HexabitzPlatform/P01R0x-Hardware/README.md

# P01R0x-Hardware
Hexabitz RGB LED Module Hardware Design
