HexabitzPlatform/P01R0x-Hardware/Released/BOM/P01R0.xlsx

 |  | www.hexabitz.com info@hexabitz.com |  | Bill Of Materials
Customer | Hexabitz | Revision | 1
Project | Hexabitz Modules | Date | 2024-02-21
Board | RGB LED (P01R0) | Notes
Designator | Description | Manufacturer | Manufacturer Part Number | Octopart Url | Quantity
R | Conn Unshrouded Header HDR 1 POS Solder ST Top Entry Thru-Hole Carton | TE Connectivity | 103327-1 | https://octopart.com/103327-1-te+connectivity-1934117?r=sp | 1
SWD | Conn Unshrouded Header HDR 3 POS 2.54mm Solder ST Top Entry Thru-Hole Carton | TE Connectivity | 5-146281-3 | https://octopart.com/5-146281-3-te+connectivity+%2F+amp-39745942?r=sp | 1
C1, C5, C6 | CAP CER 0.1 UF 10% X7R 0603 | KEMET | C0603C104K8RACTU | https://octopart.com/c0603c104k8ractu-kemet-145075?r=sp&s=9bS9ASSwSEqMCE9KBEQZ0g | 3
C2 | CAP CER 1 UF 16V X7R 0805 | YAGEO | CC0805KKX7R7BB105 | https://octopart.com/cc0805kkx7r7bb105-yageo-8376555?r=sp | 1
C7 | CAP TANT 4.7 UF 10V 20% 0805 | Panasonic | 10TPU4R7MSI | https://octopart.com/10tpu4r7msi-panasonic-29487748?r=sp | 1
R1 | Thick Film Resistors - SMD 0603 270 Ohm 5% Tol | Panasonic | ERJ-3GEYJ271V | https://octopart.com/erj-3geyj271v-panasonic-55560546?r=sp | 1
R2 | RES SMD 0.0OHM JUMPER 1/10W 0603 | YAGEO | RC0603JR-070RL | https://octopart.com/rc0603jr-070rl-yageo-1241539?r=sp | 1
R3 | RES 10K Ohm 5% 0603 | Vishay | CRCW060310K0JNEB | https://octopart.com/crcw060310k0jneb-vishay-46603269 | 1
R4 | Thick Film Resistors - SMD 0603 68 Ohm 1% | Vishay | CRCW060368R0FKEA | https://octopart.com/crcw060368r0fkea-vishay-39811903 | 1
R5, R6 | Thick Film Resistors - SMD 0603 10 Ohm 1% | Vishay | CRCW060310R0FKEB | https://octopart.com/crcw060310r0fkeb-vishay-42507905 | 2
R7, R8, R9 | Thick Film Resistors - SMD 0603 2.4K Ohm 1% | Vishay | CRCW06032K40JNEA | https://octopart.com/crcw06032k40jnea-vishay-40298967 | 3
FB1 | Ind chip Bead Multi-Layer 30 ohms 25% 100MHZ Ferrite 1,5A 0603Punched paper T/R | TDK | MMZ1608Y300BTA00 | https://octopart.com/mmz1608y300bta00-tdk-7906990?r=sp | 1
Q1, Q2, Q3 | Transistor, Bipolar, Si, NPN, General Purpose, VCEO 40VDC, IC 200mA, PD 225mW, SOT-23 | ON Semiconductor | MMBT3904LT1G | https://octopart.com/mmbt3904lt1g-on+semiconductor-3280?r=sp | 3
U1 | MCU 32-Bit ARM Cortex-M0+ RISC 512kByte Flash 1.7V to 3.6V 48-Pin UFQFPN Tray | STM32G0B1CEU6 | STMicroelectronics | https://octopart.com/stm32g0b1ceu6-stmicroelectronics-116363364?r=sp | 1
D1 | Red 0603 130° Clear 54 mcd 2 V Surface Mount ChipLED | Vishay | VLMS1300-GS08 | https://octopart.com/vlms1300-gs08-vishay-21709201?r=sp&s=0nXJNjGsSbWwqfqWlZv0EA | 1
D2 | LED, HB, RGB, SMD, 130mW | Wolfspeed (https://octopart.com/manufacturers/wolfspeed) | CLVBA-FKA-CC1F1L1BB7R3R3 | https://octopart.com/clvba-fka-cc1f1l1bb7r3r3-cree-20054005 | 1
D3 | TVS DIODE 3,3V 10,9V SOD323 | BOURNS | CDSOD323-T03SC | https://octopart.com/cdsod323-t03sc-bourns-10487153?r=sp | 1
X1 | 8,0000MHZ 33pF SMD MURATA Resonators | Murata | CSTNE8M00G550000R0 | https://octopart.com/cstne8m00g550000r0-murata-91406934?r=sp | 1
