HexabitzPlatform/P01R0x-Hardware/Documentation/P01R0_Schematics.pdf

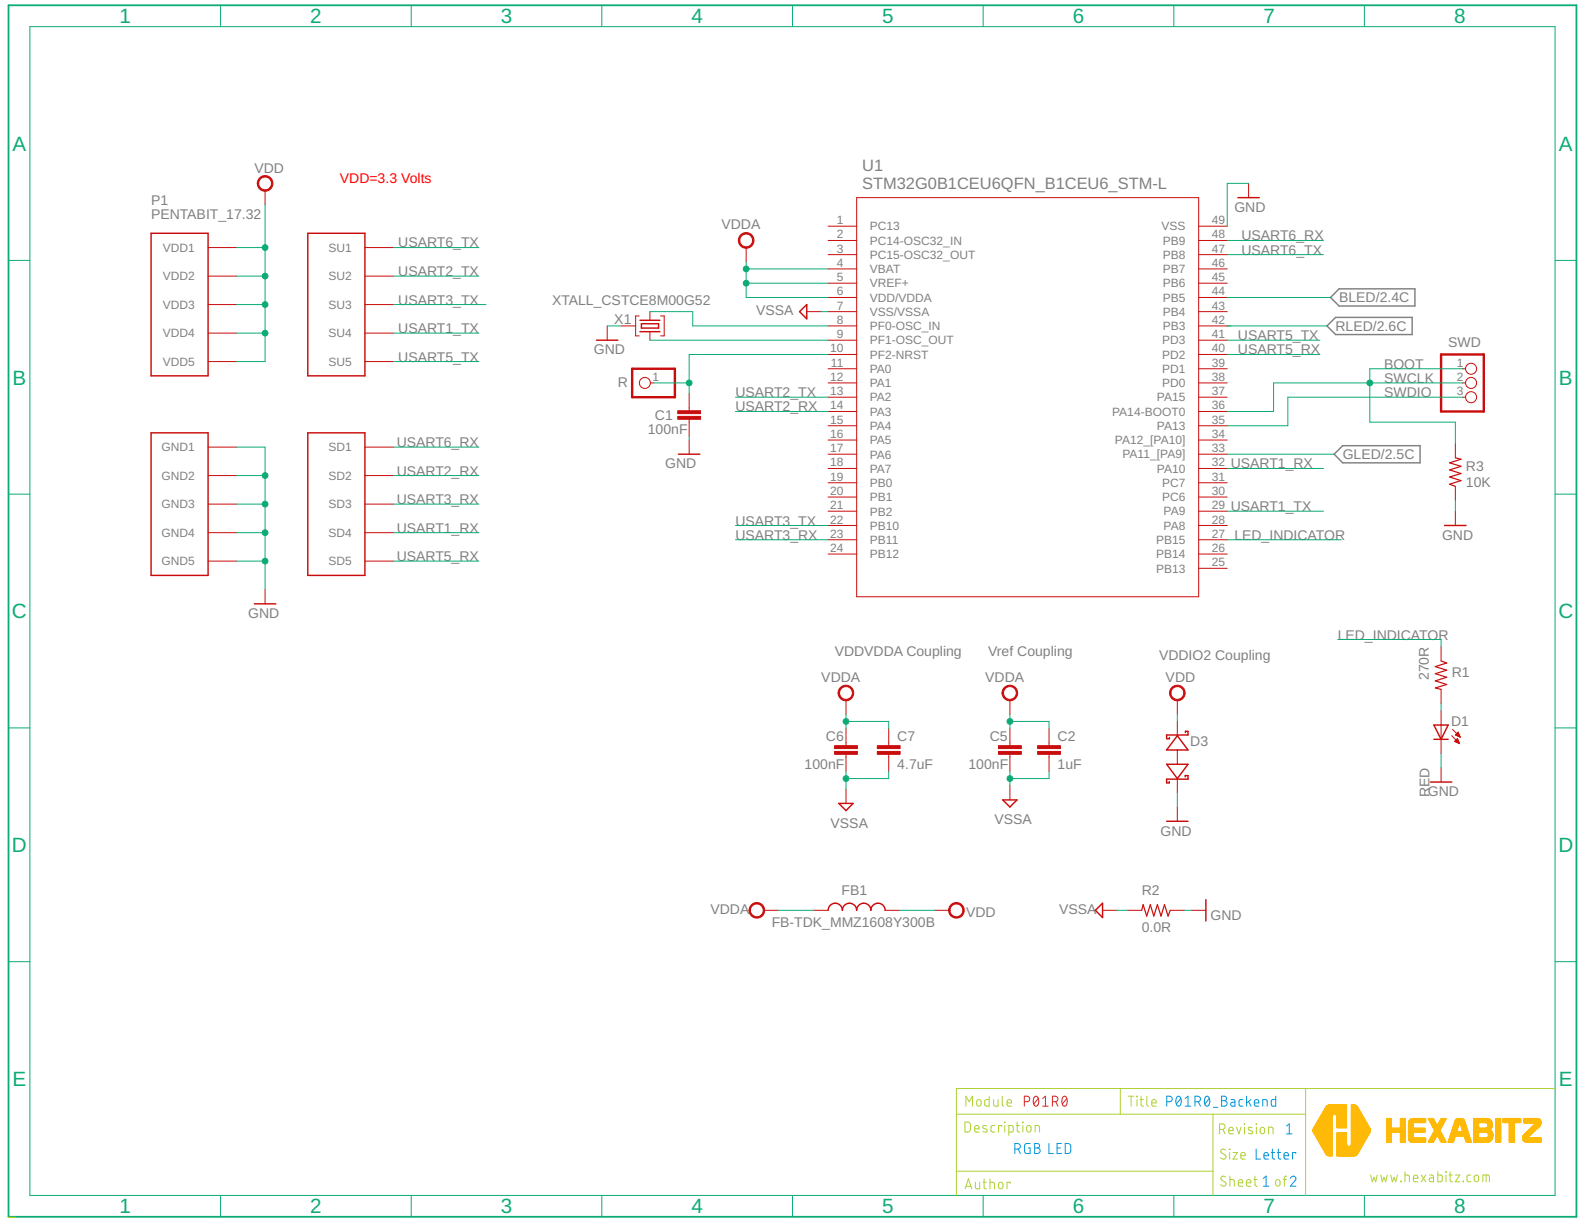
[picture p1: page 1]

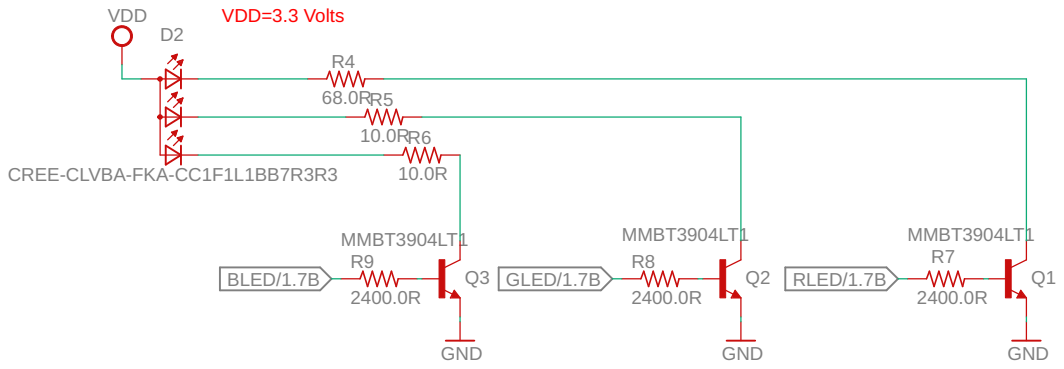
[picture p2: page 2]
