HexabitzPlatform/P01R0x-Hardware/Design/P01R0.brd

## EAGLE design Design/P01R0.brd (2024-07-14)

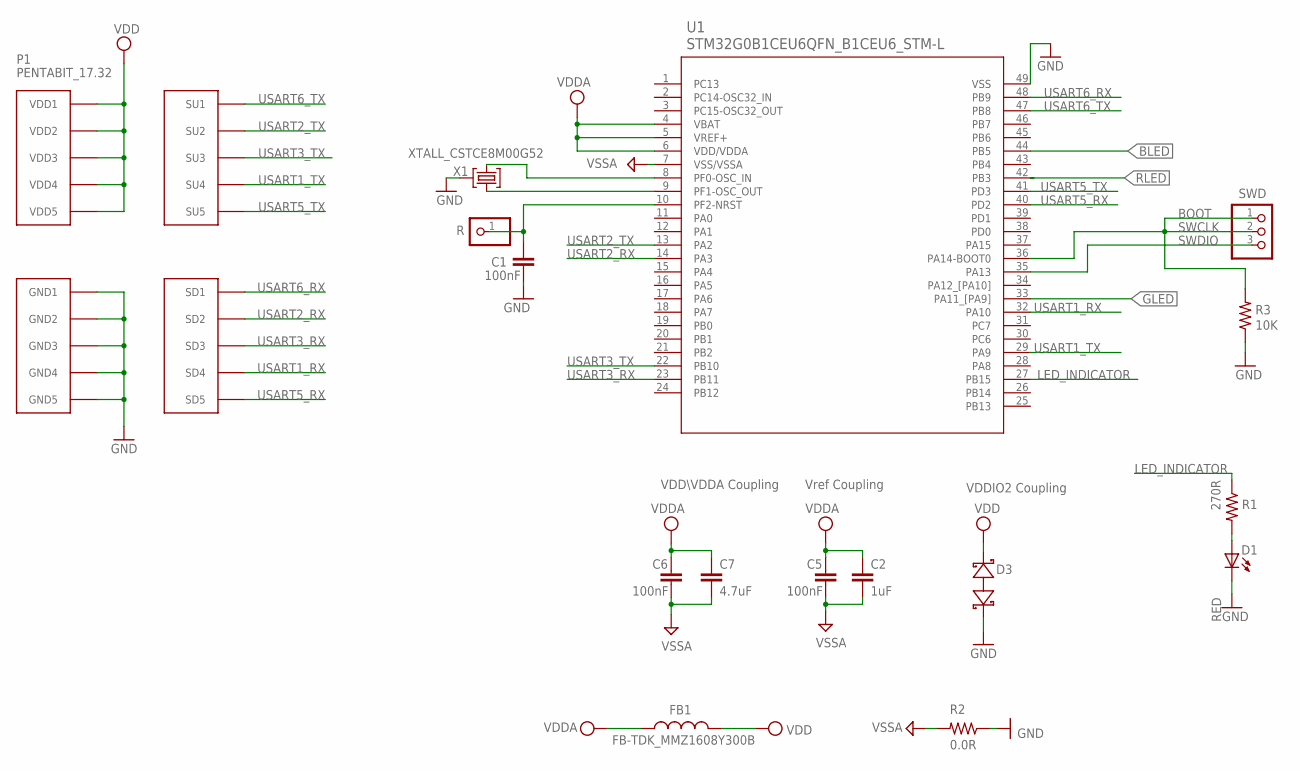
[picture p3: schematic P01R0.sch, sheet 1]

Parts:
C1, C5, C6: 100nF; C-0603
C2: 1uF; C-0805
C7: 4.7uF; C-0805
D1: RED; VLMS1300-GS08; MPN VLMS1300-GS08
D3: BOURNS_CDSOD323-T03SCBOURNS_CDSOD323-T03SC_0_0; BOURNS_CDSOD323-T03SC_0
FB1: FB-TDK_MMZ1608Y300B; FB-0603; MPN MMZ1608Y300B
P1: PENTABIT_17.32
R: R; 1X01
R1: 270R; R-0603
R2: 0.0R; R-0603; MPN RC0603JR-070RL
R3: 10K; R-0603
SWD: PINHD-1X3; 1X03
U1: STM32G0B1CEU6QFN_B1CEU6_STM-L; QFN_B1CEU6_STM-L
X1: XTALL_CSTCE8M00G52

Connections:
BLED: U1.44 (PB5); also elsewhere on the board
GLED: U1.33 (PA11_[PA9]); also elsewhere on the board
GND: C1.2, D1.C, D3.1 (A), P1.PAD_PD6 (GND1), P1.PAD_PD7 (GND2), P1.PAD_PD8 (GND3), P1.PAD_PD9 (GND4), P1.PAD_PD10 (GND5), R2.1, R3.1, U1.49 (VSS), X1.P$2 (2); also elsewhere on the board
LED_INDICATOR: R1.1, U1.27 (PB15)
unnamed: D1.A, R1.2
OSC_IN: U1.8 (PF0-OSC_IN), X1.P$3 (3)
OSC_OUT: U1.9 (PF1-OSC_OUT), X1.P$1 (1)
R: C1.1, R.1, U1.10 (PF2-NRST)
RLED: U1.42 (PB3); also elsewhere on the board
SWCLK: R3.2, SWD.1, SWD.2, U1.36 (PA14-BOOT0)
SWDIO: SWD.3, U1.35 (PA13)
USART1_RX: P1.PAD_PD4 (SD4), U1.32 (PA10)
USART1_TX: P1.PAD_PU4 (SU4), U1.29 (PA9)
USART2_RX: P1.PAD_PD2 (SD2), U1.14 (PA3)
USART2_TX: P1.PAD_PU2 (SU2), U1.13 (PA2)
USART3_RX: P1.PAD_PD3 (SD3), U1.23 (PB11)
USART3_TX: P1.PAD_PU3 (SU3), U1.22 (PB10)
USART5_RX: P1.PAD_PD5 (SD5), U1.40 (PD2)
USART5_TX: P1.PAD_PU5 (SU5), U1.41 (PD3)
USART6_RX: P1.PAD_PD1 (SD1), U1.48 (PB9)
USART6_TX: P1.PAD_PU1 (SU1), U1.47 (PB8)
VDD: D3.2 (C), FB1.2, P1.PAD_PU6 (VDD1), P1.PAD_PU7 (VDD2), P1.PAD_PU8 (VDD3), P1.PAD_PU9 (VDD4), P1.PAD_PU10 (VDD5); also elsewhere on the board
VDDA: C2.1, C5.1, C6.1, C7.1, FB1.1, U1.4 (VBAT), U1.5 (VREF+), U1.6 (VDD/VDDA)
VSSA: C2.2, C5.2, C6.2, C7.2, R2.2, U1.7 (VSS/VSSA)

Notes on the sheet:
Vref Coupling
VDDIO2 Coupling
VDD\VDDA Coupling
BOOT

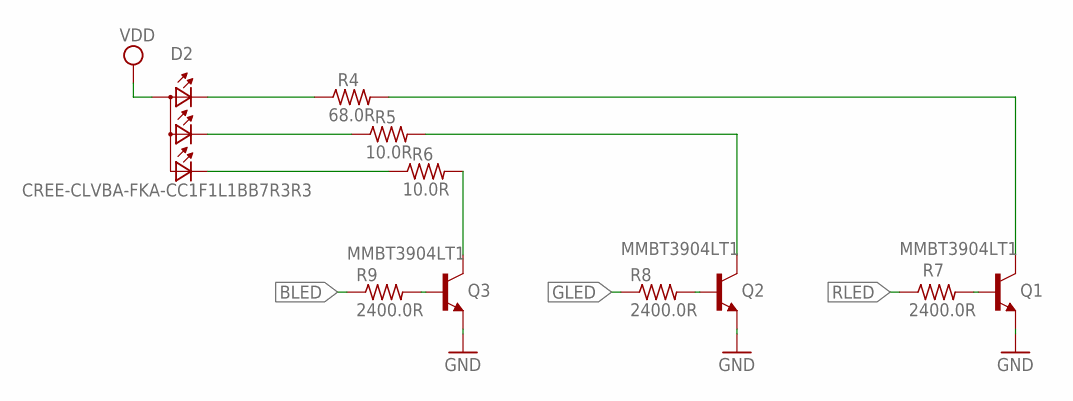
[picture p4: schematic P01R0.sch, sheet 2]

Parts:
D2: CREE-CLVBA-FKA-CC1F1L1BB7R3R3; PCB-1023943-1; MPN CLVBA-FKA-CC1F1L1BB7R3R3
Q1, Q2: MMBT3904LT1; VOLTAGE_RATING_DC 40.0V
Q3: MMBT3904LT1; VOLTAGE_RATING_DC 40.0V; MPN MMBT3904LT1G
R4: 68.0R; R-0603; TOLERANCE 1%; MPN CRCW060368R0FKEA
R5, R6: 10.0R; R-0603; TOLERANCE 1%; MPN CRCW060310R0FKEB
R7, R8, R9: 2400.0R; R-0603; TOLERANCE 5%; MPN CRCW06032K40JNEA
TRIMBLE-LOGO1: HEXA-LOGO

Connections:
BLED: R9.1; also elsewhere on the board
GLED: R8.1; also elsewhere on the board
GND: Q1.2 (E), Q2.2 (E), Q3.2 (E); also elsewhere on the board
KA_B: D2.P$3 (CBLUE), R6.1
KA_G: D2.P$4 (CGREEN), R5.1
KA_R: D2.P$1 (CRED), R4.1
unnamed: Q3.1 (B), R9.2
unnamed: Q2.1 (B), R8.2
unnamed: Q1.1 (B), R7.2
Q1C: Q1.3 (C), R4.2
Q2C: Q2.3 (C), R5.2
Q3C: Q3.3 (C), R6.2
RLED: R7.1; also elsewhere on the board
VDD: D2.P$2 (A2); also elsewhere on the board

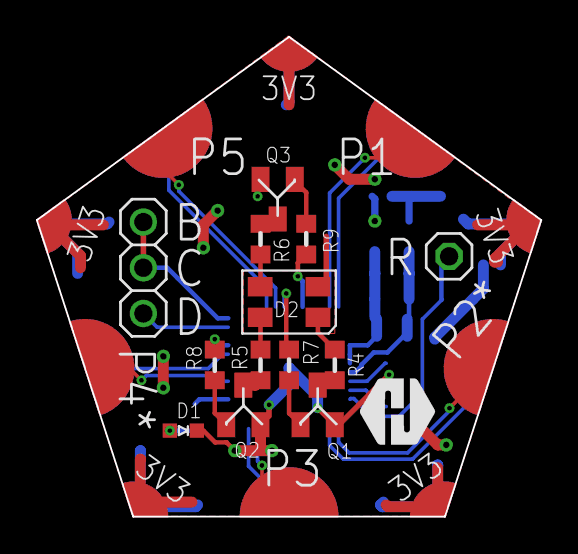
[picture p5: board P01R0.brd from above]

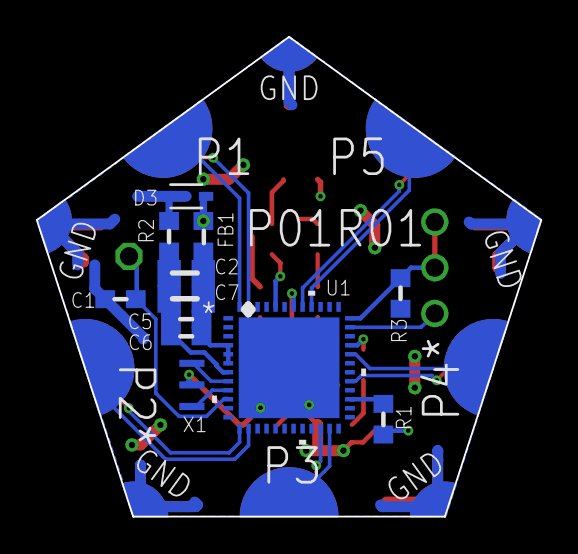
[picture p6: board P01R0.brd from below]

Board: 2 copper layers, 28.0 x 26.6 mm, 27 parts (12 on the bottom side), 33 nets.
