HexabitzPlatform/P01R0x-Hardware/(commit log)

2024-01-30 -Intial template
    [P01R0.brd, P01R0.sch]
2024-01-30 -Editing the BOM
    [P01R0.xlsx]
2024-02-25 -Changing the MCU to STM32G0B1CEU6N -Adding TVS 3.3V -Reviewed version , all finish
    [P01R0.brd, P01R0.sch, P01R0.xlsx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]
2024-04-02 Update the Logo
    [P01R0.brd, P01R0.sch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]
2024-07-14 -Add TVS diode -Change the MCU to STM32G0B1CEU6 -Activate the thermal option for the polygon -Improve the layout design for better appearence
    [P01R0.brd, P01R0.sch, P01R0.xlsx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]
2024-07-14 -Fix the BOM
    [P01R0.xlsx]
